rglenn/ottawa-badges-2016/README.md

# ottawa-badges-2016
Maker badges for Maker Faire Ottawa 2016
