rglenn/ottawa-badges-2016/pcb/ottawa-badges-2016.pdf

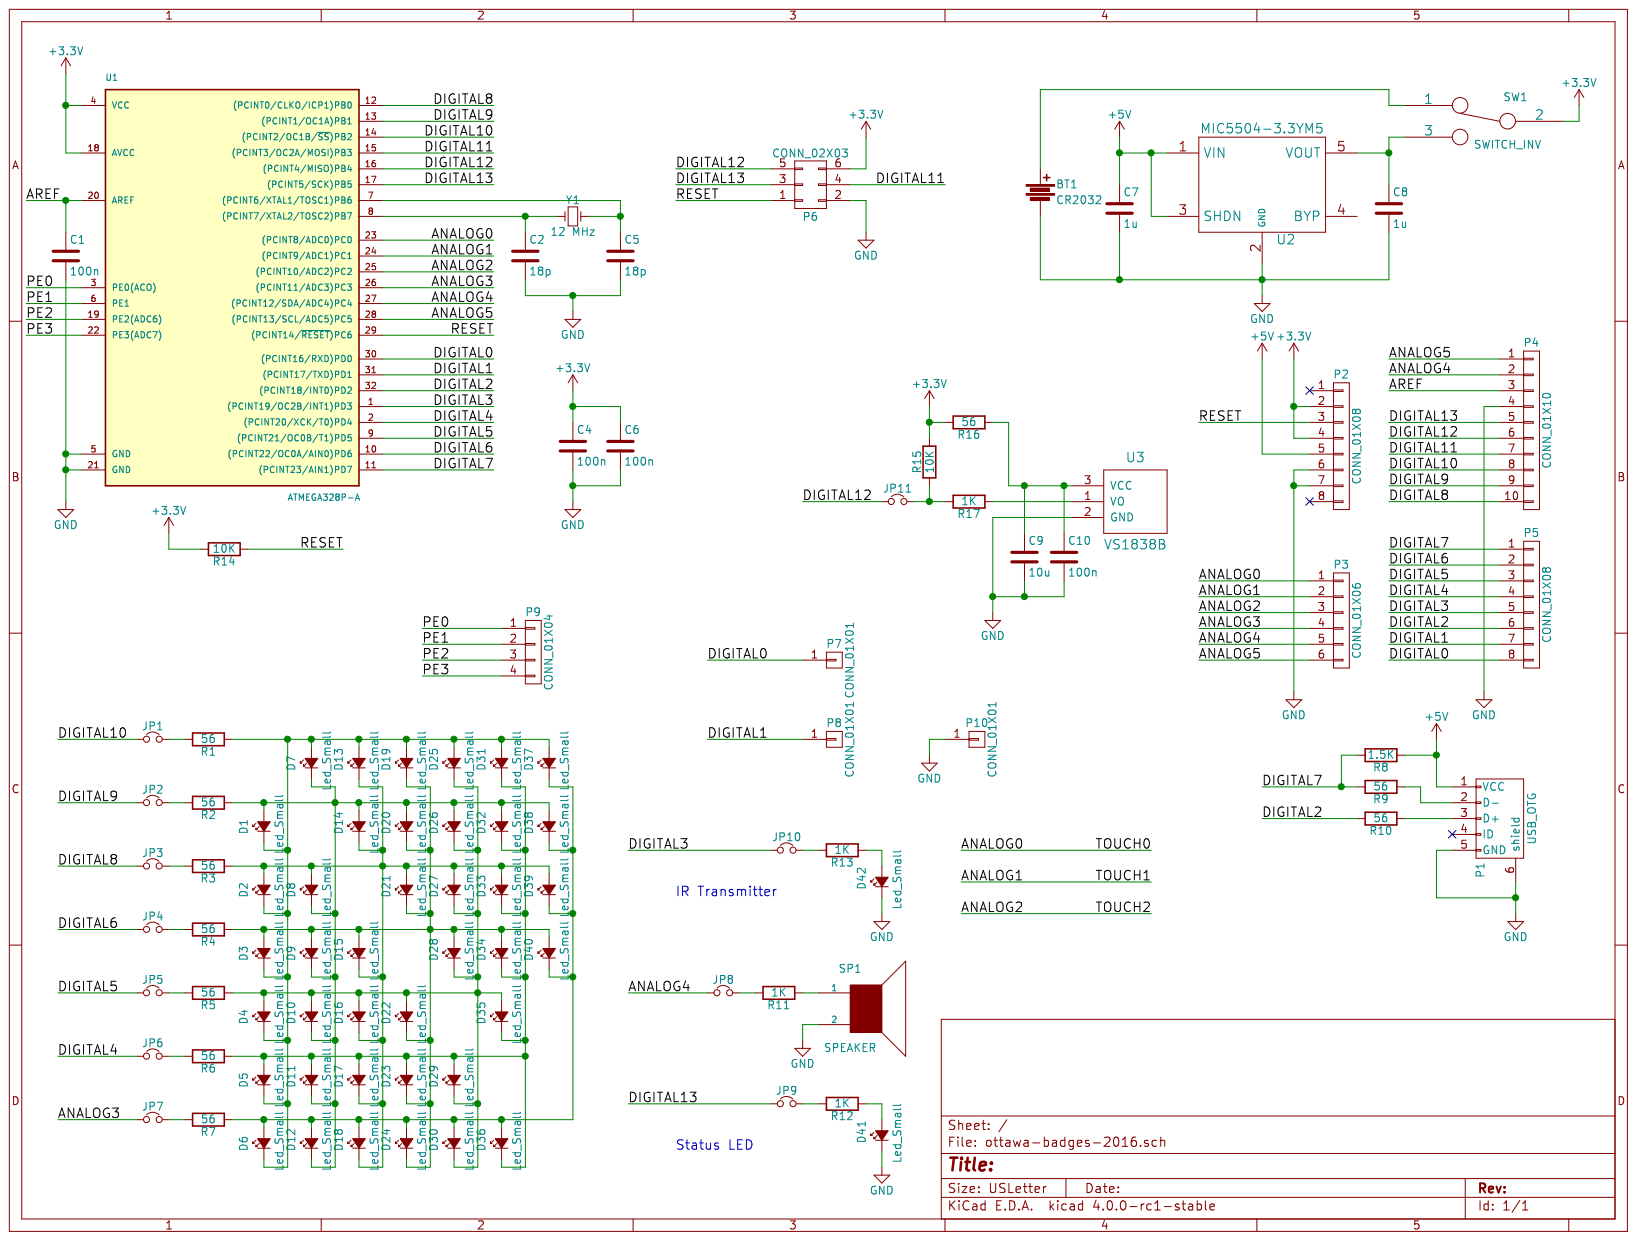
[picture p1: page 1]
