rglenn/ottawa-badges-2016/tagger/pcb/ottawa-badge-tagger-2016.kicad_pcb

## KiCad design tagger/pcb/ottawa-badge-tagger-2016.kicad_pcb (2016-08-10)

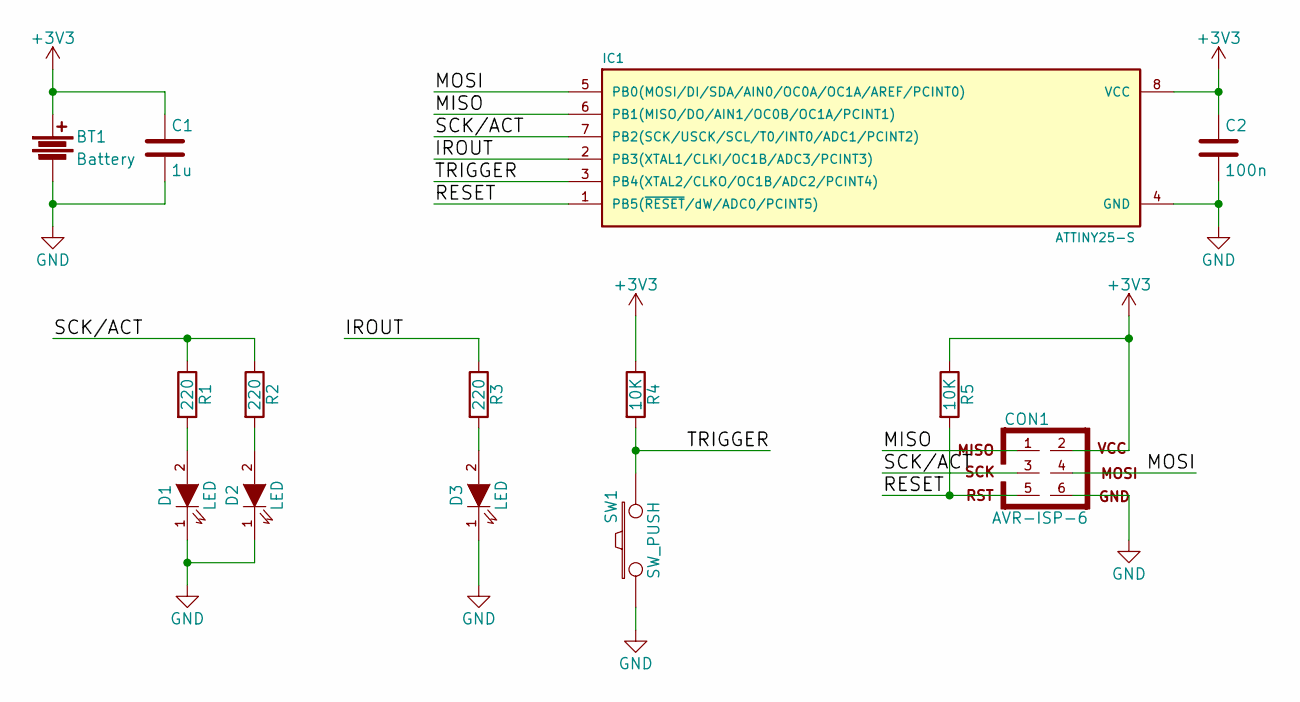
[picture p5: schematic ottawa-badge-tagger-2016.sch]

Parts:
BT1: Battery; CR2032-SHRAPNEL
C1: 1u; C_0805
C2: 100n; C_0603
CON1: AVR-ISP-6; Pin_Header_Straight_2x03
D1, D2: LED; LED-3MM
D3: LED; LED-5MM
IC1: ATTINY25-S; SOIJ-8_5.3x5.3mm_Pitch1.27mm
R1, R2, R3: 220; R_0603
R4, R5: 10K; R_0603
SW1: SW_PUSH; SW_TH_Tactile_Omron_B3F-10xx

Connections:
+3V3: BT1.1, C1.1, C2.1, CON1.2, IC1.8 (VCC), R4.1, R5.1
/IROUT: IC1.2 (PB3(XTAL1/CLKI/OC1B/ADC3/PCINT3)), R3.1
/MISO: CON1.1, IC1.6 (PB1(MISO/DO/AIN1/OC0B/OC1A/PCINT1))
/MOSI: CON1.4, IC1.5 (PB0(MOSI/DI/SDA/AIN0/OC0A/OC1A/AREF/PCI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)
/RESET: CON1.5, IC1.1 (PB5(~RESET~/dW/ADC0/PCINT5)), R5.2
/SCK/ACT: CON1.3, IC1.7 (PB2(SCK/USCK/SCL/T0/INT0/ADC1/PCINT2)), R1.1, R2.1
/TRIGGER: IC1.3 (PB4(XTAL2/CLKO/OC1B/ADC2/PCINT4)), R4.2, SW1.2
GND: BT1.2, C1.2, C2.2, CON1.6, D1.1 (K), D2.1 (K), D3.1 (K), IC1.4 (GND), SW1.1
unnamed: D1.2 (A), R1.2
unnamed: D2.2 (A), R2.2
unnamed: D3.2 (A), R3.2

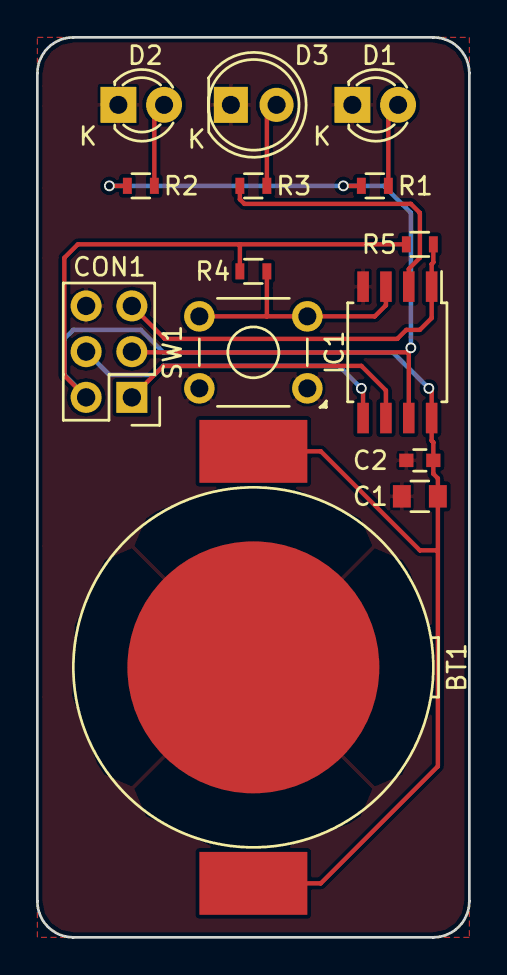
[picture p6: board ottawa-badge-tagger-2016.kicad_pcb from above]

Board: 2 copper layers, 24.0 x 50.0 mm, 14 parts (0 on the bottom side), 11 nets.
