rglenn/ottawa-badges-2016/(commit log)

2016-06-15 Adding schematic in progress. Still need to add microphone section, IR receiver, optional ESP8266, and optional Neopixels.
    [ottawa-badges-2016.kicad_pcb, ottawa-badges-2016.sch]
2016-06-15 Adding PDF of schematic
    [ottawa-badges-2016.sch]
2016-06-17 Started layout of board.
    [ottawa-badges-2016.kicad_pcb, ottawa-badges-2016.sch]
2016-06-17 Added touch pads.
    [ottawa-badges-2016.kicad_pcb]
2016-06-17 Shrunk the LED matrix a bit.
    [ottawa-badges-2016.kicad_pcb]
2016-06-21 MANY CHANGES. Added footprints for USB connector, battery clip, power switch, and solder jumper. Started adding banana jack "sockets".
    Need to place the banana jacks, and add the IR receiver and artwork. Then I think we're done for the prototype.
    [ottawa-badges-2016.kicad_pcb, ottawa-badges-2016.sch]
2016-06-24 Added IR receiver and Maker Faire logo. Still need to add Makey for prototype. Also need to figure out where to put P8 so that it doesn't overlap with the logo.
    [ottawa-badges-2016.kicad_pcb, ottawa-badges-2016.sch]
2016-06-24 Moved P8 to other side of the board, moved battery holder to accommodate that.
    [ottawa-badges-2016.kicad_pcb]
2016-08-03 Just about ready for prototypes!
    [ottawa-badges-2016.kicad_pcb]
2016-08-10 Generated Gerber files and added tact switch to badge part library
    [ottawa-badges-2016-B_Cu.gbl, ottawa-badges-2016-B_Mask.gbs, ottawa-badges-2016-B_SilkS.gbo, ottawa-badges-2016-Edge_Cuts.gm1, ottawa-badges-2016-F_Cu.gtl, ottawa-badges-2016-F_Mask.gts, ottawa-badges-2016-F_Paste.gtp, ottawa-badges-2016-F_SilkS.gto]
2016-08-10 Added tagger board for playing badge tag
    [ottawa-badge-tagger-2016-B_Cu.gbl, ottawa-badge-tagger-2016-B_Mask.gbs, ottawa-badge-tagger-2016-B_SilkS.gbo, ottawa-badge-tagger-2016-Edge_Cuts.gm1, ottawa-badge-tagger-2016-F_Cu.gtl, ottawa-badge-tagger-2016-F_Mask.gts, ottawa-badge-tagger-2016-F_Paste.gtp, ottawa-badge-tagger-2016-F_SilkS.gto]
2016-11-17 Adding latest files from ATMega328PB version and BOM.
    [ottawa-badges-2016.kicad_pcb, ottawa-badges-2016.sch, ottawa-badges-2016_bom_chipsetter.xlsx]
2016-11-17 Single-badge BOM added. Whoops.
    [ottawa-badges-2016_bom.xlsx]
2016-11-17 Updating PDF schematic
